transistorfet/rgbnode/GALLERY.md

Gallery
-------


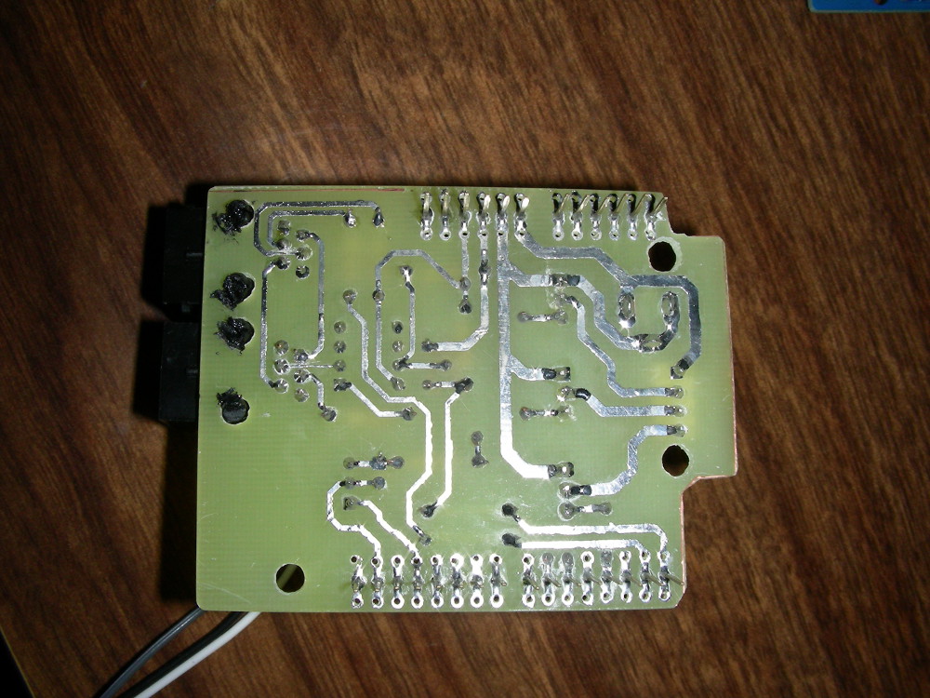
[picture p9: images/controller1-bottom.jpg]

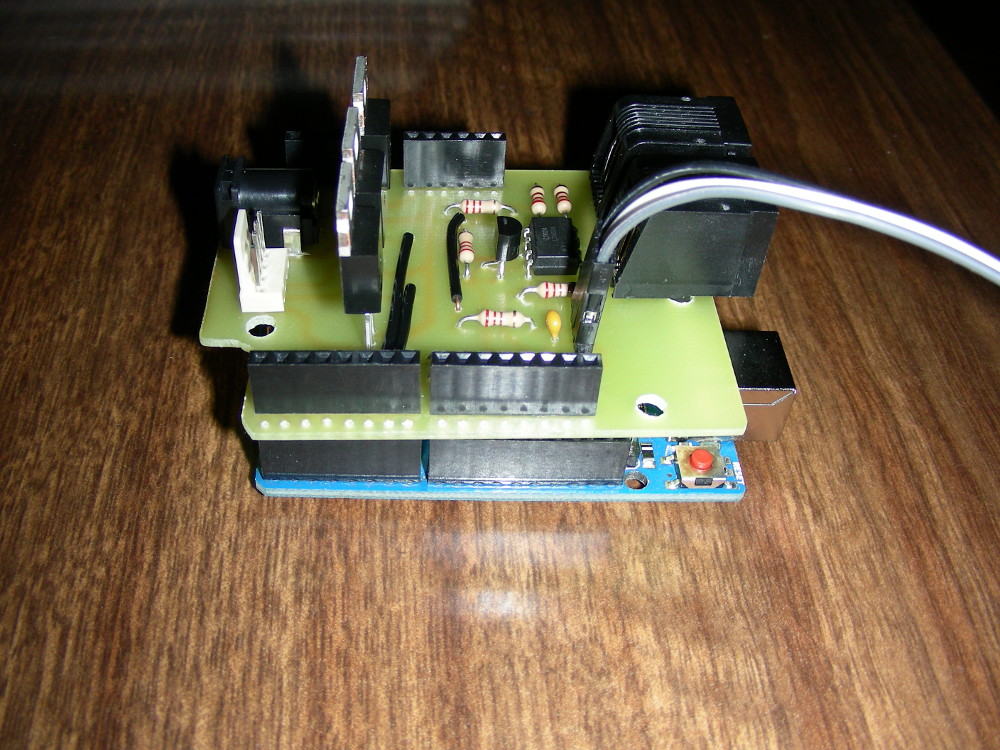
[picture p10: images/controller1.jpg]


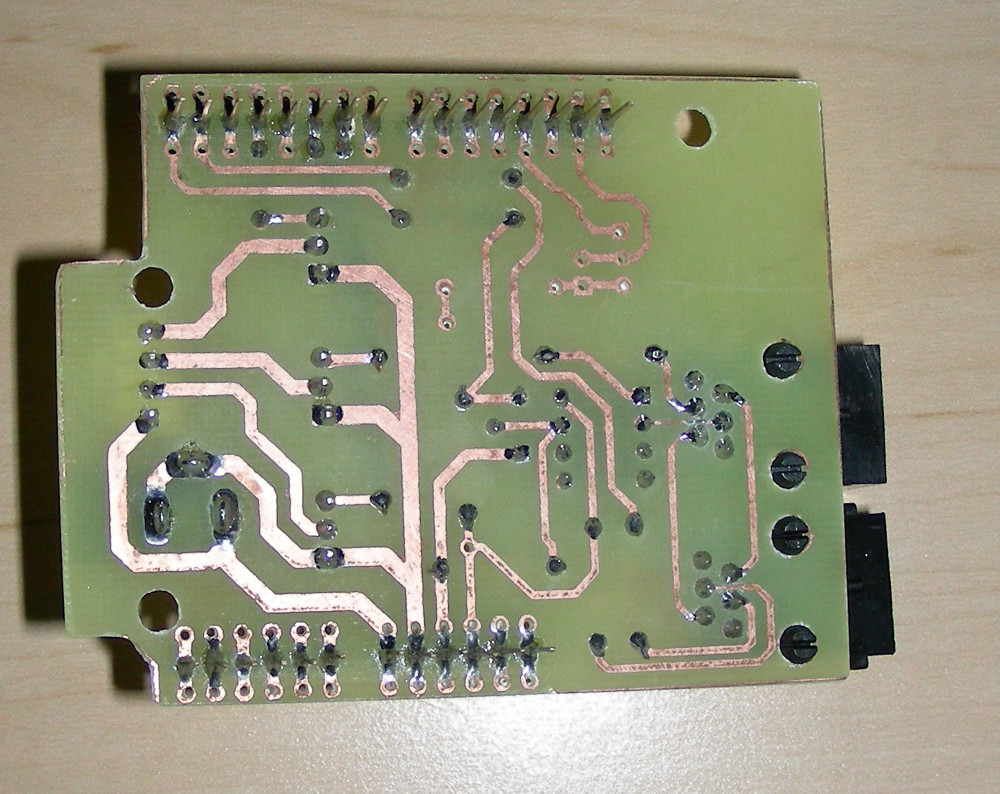
[picture p11: images/controller2-bottom.jpg]

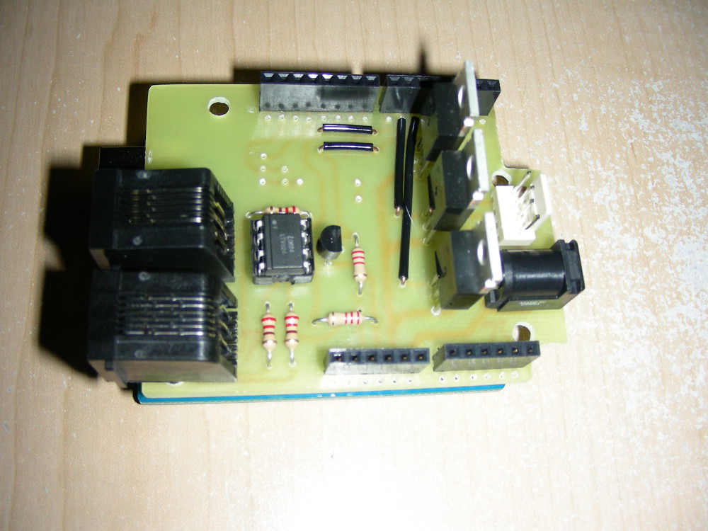
[picture p12: images/controller2-top.jpg]

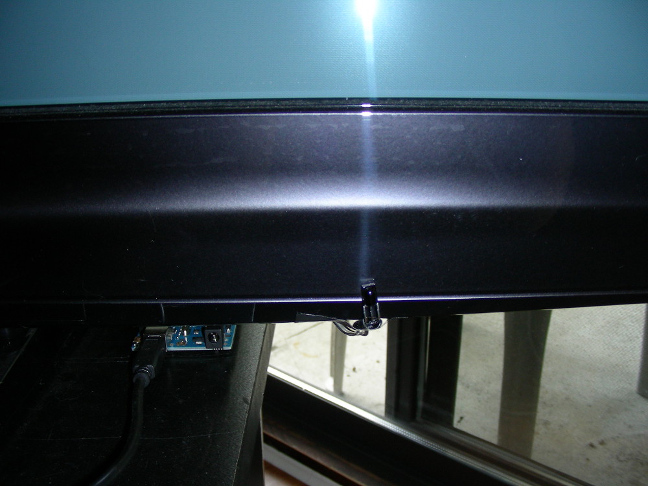
[picture p13: images/ir-receiver.jpg]

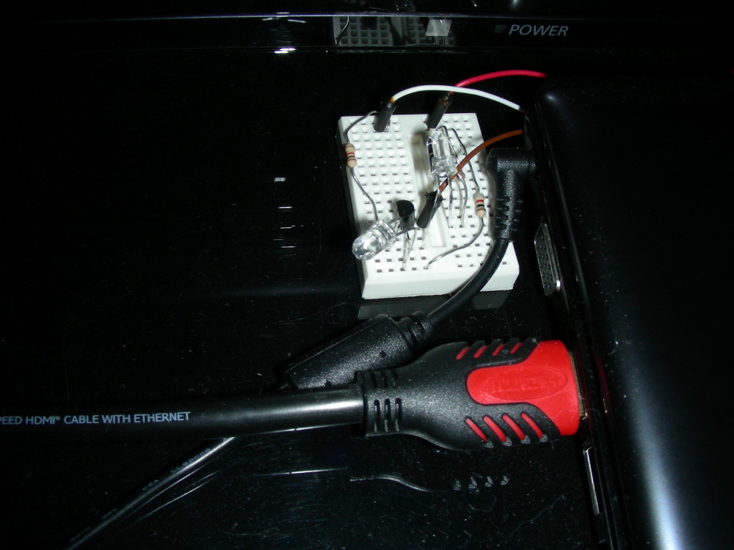
[picture p14: images/ir-transmitter.jpg]

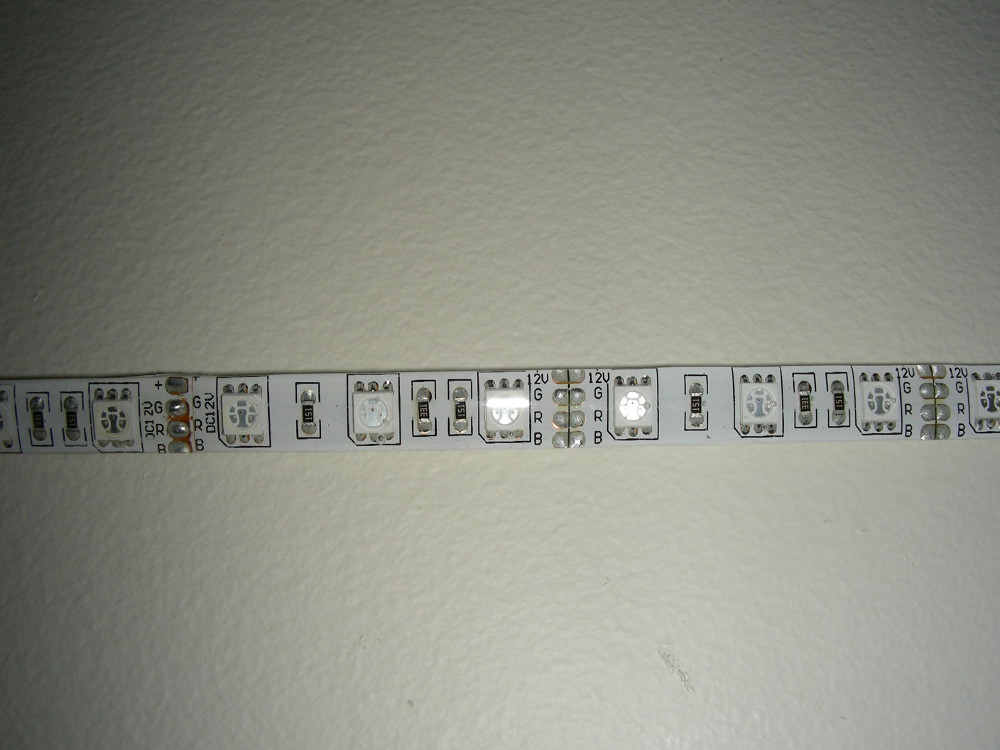
[picture p15: images/ledstrip-closeup.jpg]

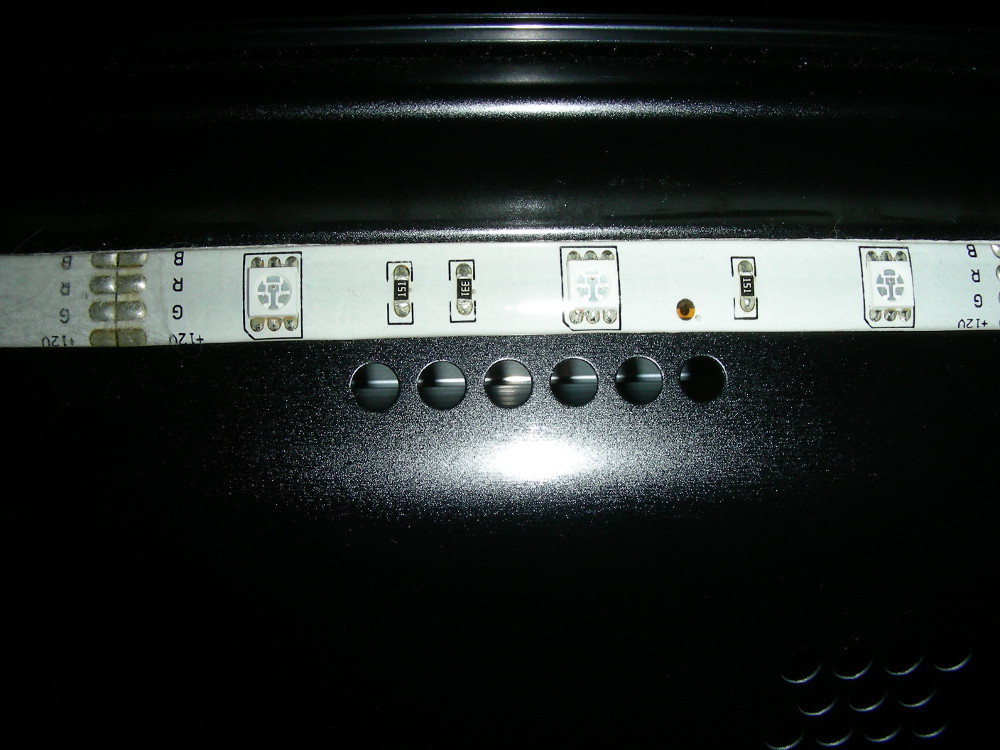
[picture p16: images/ledstrip-tv.jpg]

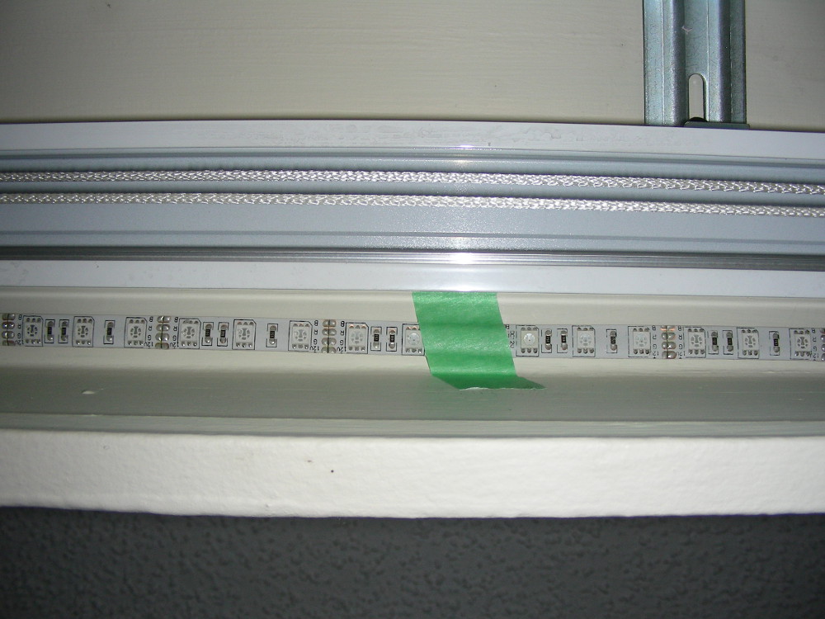
[picture p17: images/ledstrip-valance.jpg]

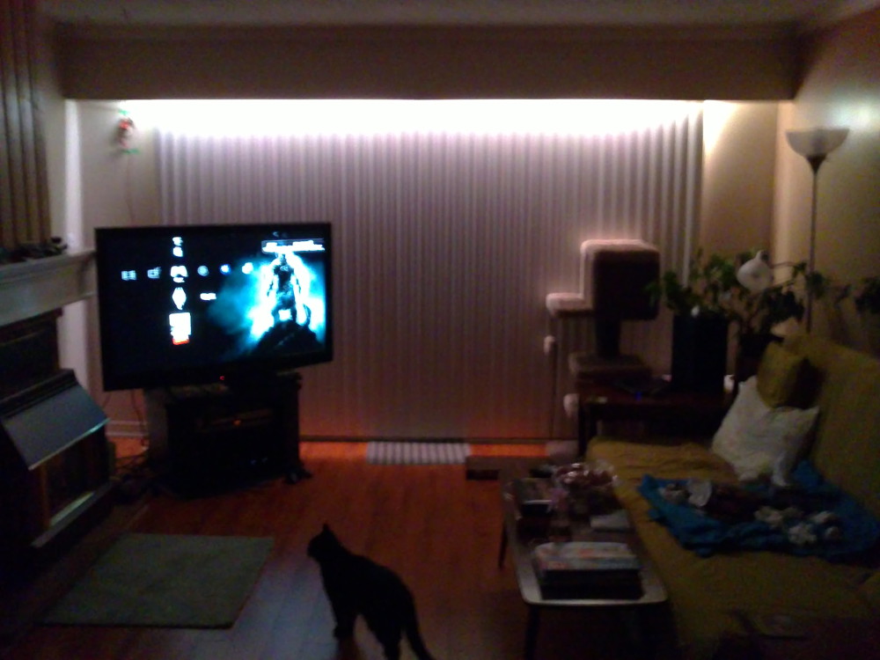
[picture p18: images/old-valance.jpg]

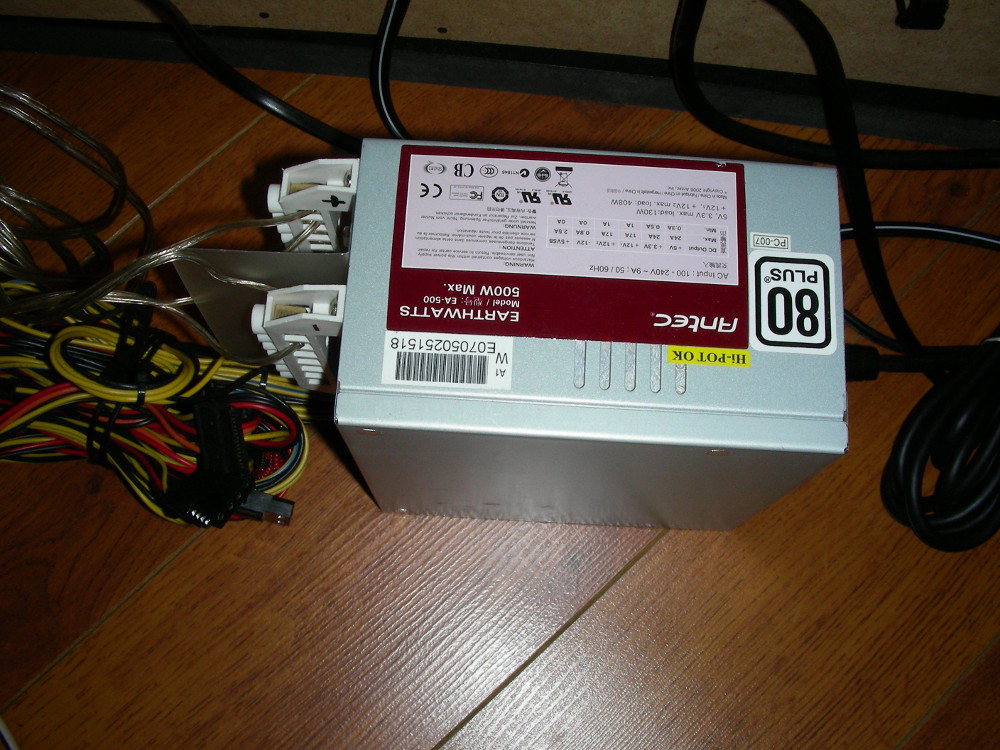
[picture p19: images/powersupply1.jpg]

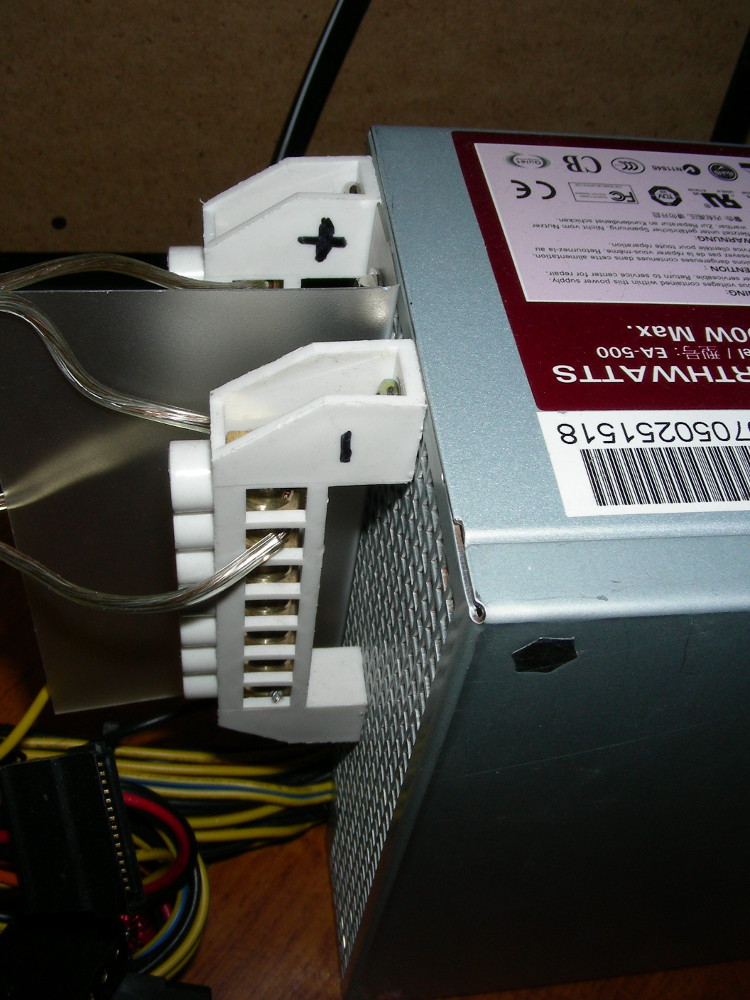
[picture p20: images/powersupply2.jpg]

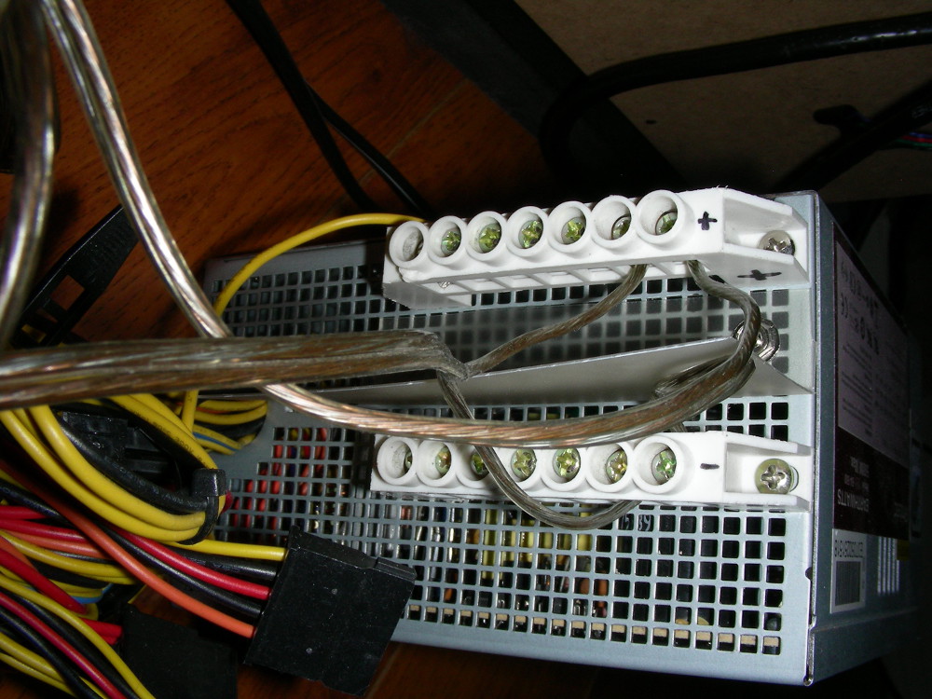
[picture p21: images/powersupply3.jpg]


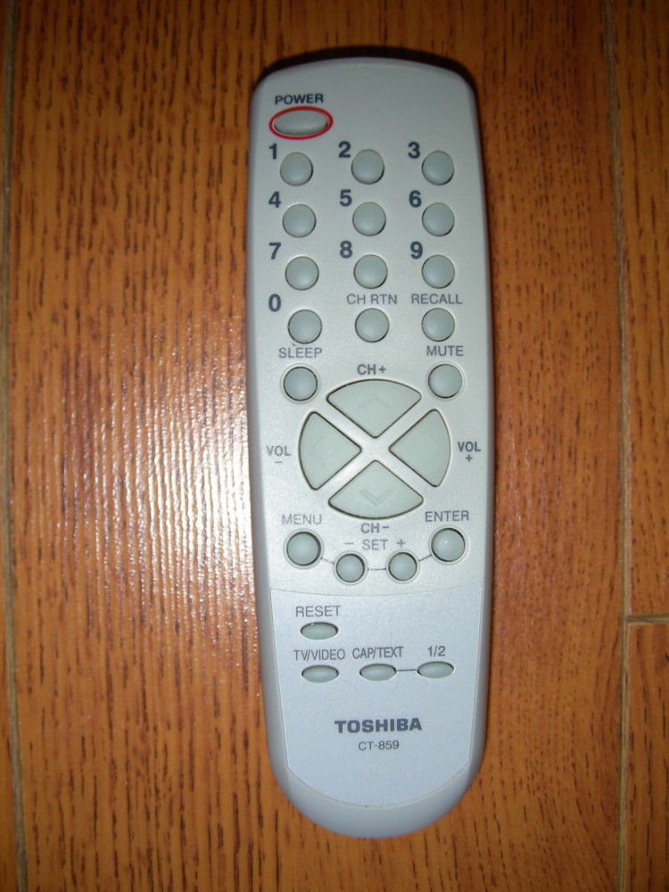
[picture p22: images/toshiba-remote.jpg]



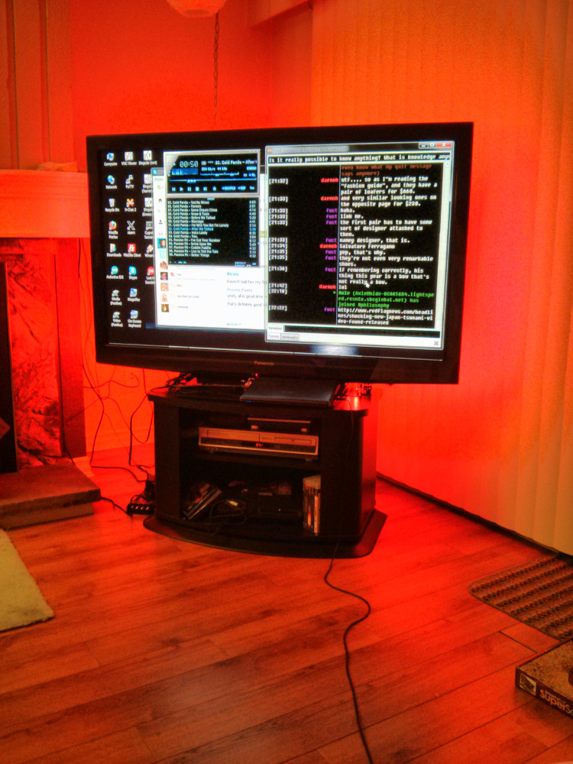
[picture p23: images/tv-red.jpg]

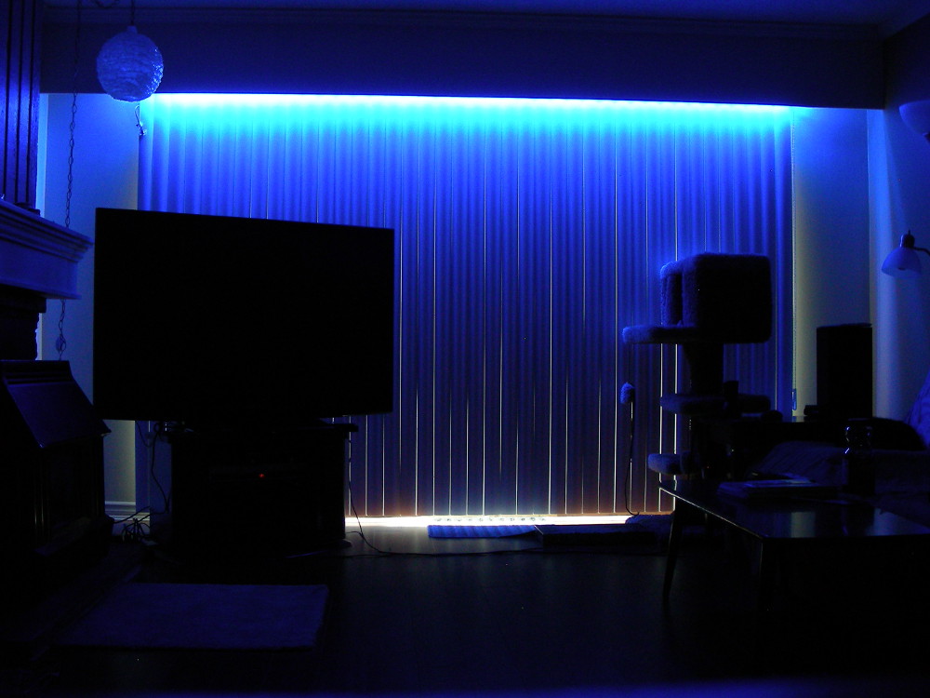
[picture p24: images/valance-blue.jpg]

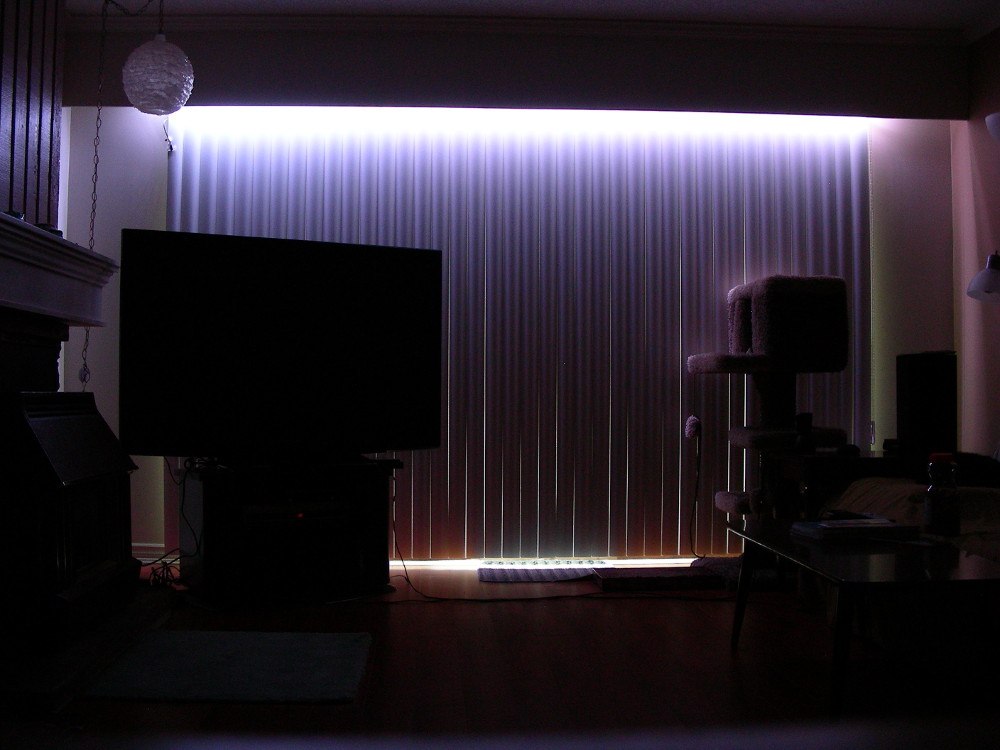
[picture p25: images/valance-coolwhite.jpg]


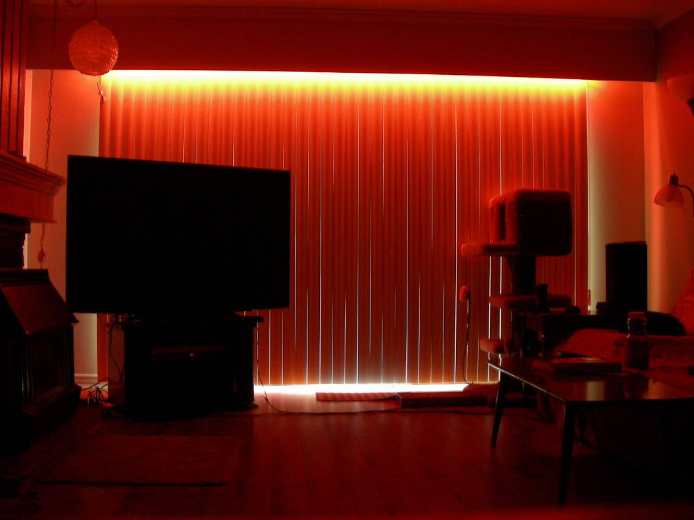
[picture p26: images/valance-orange.jpg]



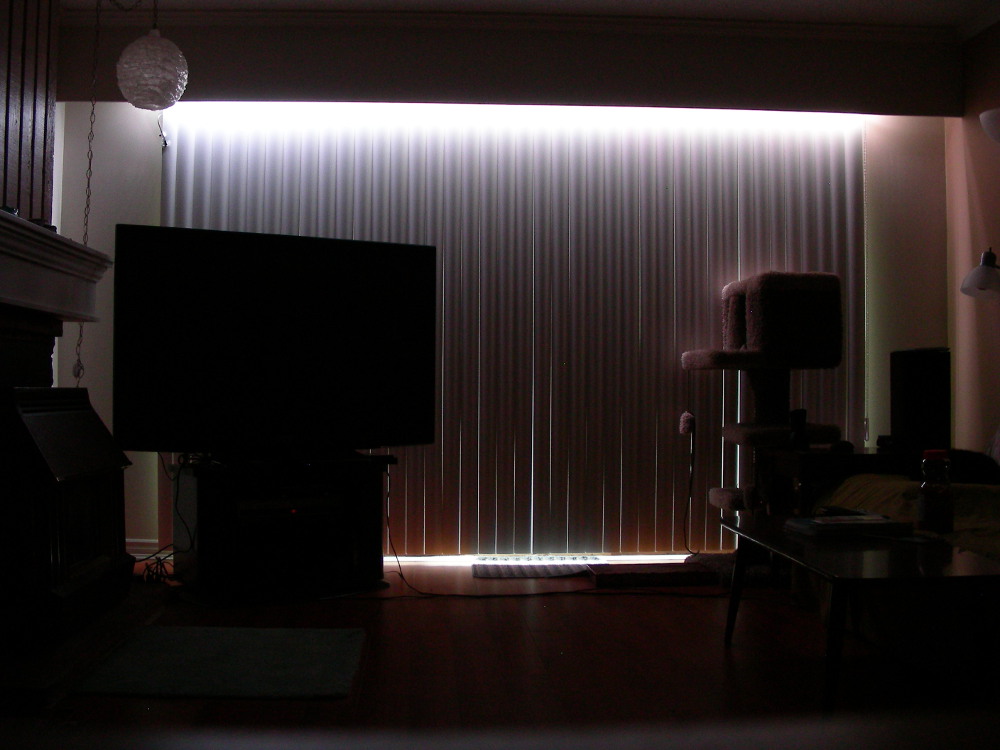
[picture p27: images/valance-warmwhite.jpg]
