transistorfet/rgbnode/docs/ledstrip-shield-with-power.pdf

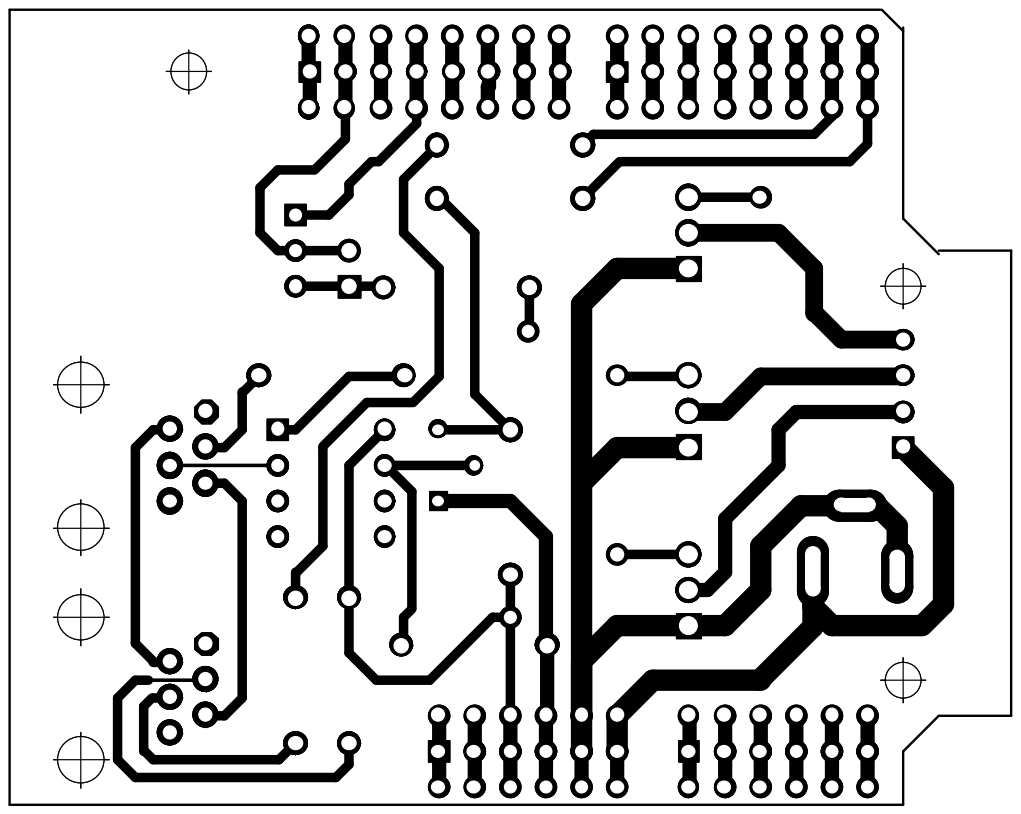
[picture p28: page 1]
