transistorfet/rgbnode/(list of files, drawings)

Other design files:
archive/ledstrip-shield2.dip
archive/ledstrip-shield.dip
archive/remoteled-doublesided.dip
archive/remoteled.dip
docs/ledstrip-shield-with-power.dip
