transistorfet/rgbnode/(commit log)

2013-09-04 Initial commit. Code is stable and fully tested. It was originally based on code for the original prototype ledstrip project, and was re-written as remoteled for the arduino shields.
    [ledstrip-shield-with-power.dip]
2013-10-25 Removed debugging print statements.
2013-10-29 Fixed the flickering problem!
    [rgbnode.ino]
2014-08-31 Added relay control and implemented daisywire serial
2014-09-01 Fixed daisywire checksum, and reorganized RGB engine
    [ledstrip-shield.dip, ledstrip-shield2.dip, remoteled-doublesided.dip, remoteled.dip]
2015-10-29 Moved serial code into it's own library, and fixed many bugs
    [ledstrip-shield-with-power.dip]
2022-12-12 Modified to work with Arduino-IRremote 3.9
